alekhyageddam/BNav/HaptiGoVestCode/HaptiGoClean/Reports/IUI 2013/Haptigo Paper.pdf

# HaptiGo: An Intelligent and Lightweight Tactile Vest for Improving Active Pedestrian Navigation Experiences

Anonymous

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

Author Keywords
Mobile user interface, haptics, tactile display, pedestrian navigation, intelligent fabrics.

ACM Classification Keywords
H.5.2. User Interfaces: Haptic I/O

INTRODUCTION
As people navigate from one location to another by foot, they can take advantage of prior knowledge of their surroundings to guide themselves towards their intended destinations. Greater familiarity in their environments from this prior knowledge also enables people to engage in multi-tasking while making the most of their available time, alleviating any boredom, and so on. These parallel tasks in conjunction with navigation are also quite diverse in scope and can range from social activities, such as engaging in serious discussion with colleagues, casually texting with a friend, or talking

Submitted to IUI’13.
Do not cite, do not circulate.

to family on the phone; to more personal activities, such as listening to music with headphones, browsing information on a smartphone, or playing video games on a portable gaming device.

These habits subsequently introduce two distinct challenges as people grow accustomed to multi-tasking while navigating familiar environments: the challenge of inconvenience where people must become more aware of their surroundings and navigation tools in unfamiliar environments due to lack of prior knowledge, and the serious challenge of exposing people to greater danger while navigating in more active environments [17]. While the former challenge is readily apparent, the latter challenge occurs especially to individuals who suffer from situation-induced impairments [15], which is when they lose awareness about the situation around, such as through secondary tasks and self-imposed distractions when multi-tasking during pedestrian navigation. Examples include frequent cases of people bumping into others while their attention is focused on their mobile devices [17], and the loss of situational awareness (i.e., iPod Zombie trance) while listening to loud music that have also led to rising rates of pedestrian fatalities [27].

Conventional navigation systems found on multitudes of mobile devices – especially those which typically rely on either visual or auditory modalities – prove lacking when it comes to addressing the specifics from these particular challenges. In response, various studies have shown the effectiveness of navigation solutions which instead utilize alternate tactile modalities, especially when users are cognitively occupied in performing other tasks [8]. Moreover, touch provides great appeal in communicating navigation information without simultaneously introducing mental distraction, since tactile sensory channels are hardly affected when utilized to observe peoples surroundings [27]. According to related theoretical frameworks [8, 36], the tactile modality has great appeal as it can serve to guide, reduce workload, and support situation and navigation performance.

There is great potential in developing an effective tactile navigation system which supports the types of behaviors contained in these challenges. We therefore propose HaptiGo, a lightweight haptic vest which provides navigation intelligence of tactilely guiding pedestrians to their intended destinations and away from potential obstacles through well-placed vibro-tactile sensors, while providing natural and small form factor interaction cues which emulate the invisible sensation of being passively guided in the right direction.

We individually evaluated our vest on a group of pedestrians navigating through several different waypoints while engaged in cognitively demanding tasks, and our results demonstrated that users navigated to their destinations effectively and enjoyed our haptic interface solution.

Design Constraints
In order to design an intelligent user interface for pedestrian navigation that addressed our proposed challenges, we first had to explore design constraints that both intelligently and intuitively navigated users. The interaction analogy that inspired our design of HaptiGo was that of a friendly guide whom physically nudged the user towards the right direction and away from potential hazards.

Tactile Feedback
One analogy that we explored and expressed interest in involved interaction cues which emulated the physical action of appropriately nudging users during navigation. That is, an interaction that emulated a guide reaching out to the user and physically directing them in a friendly manner. In this case, we desired a tactile interface which provided feedback on the user’s upper torso area, since it was an ideal region for providing emulated interaction cues in nudging a person towards and away from points of interest.

Navigation Guidance
Once we established on a desired model of the tactile feedback, we needed to decide on interaction cues which serve to guide the users effectively and intuitively. The analogy that we sought was one where a guide would gently nudge users to the desired area, such as tapping the user from behind towards the intended direction.

Obstacle Avoidance
The complementary interaction of guiding users towards their target would be in guiding users away from potential hazards, so we also needed to decide on interaction cues to express that type of behavior. The analogy that interested us was a guide whom would reach out in front of the user and block the user from progressing any further due to an incoming hazard.

Example Scenarios
Our system is designed for scenarios where the users are engaged in multitasking while navigating. Th ser isn tsuch scenarios use passive awareness ofh the environment to navigate. The following scenarios illustrate the situations where a user could take advantage of our system. George is a paratrooper in airborne troops. He is on an operation that involves him to parachute into enemy territory with other Soldiers. Once he has landed, he has to reorient himself and find his way to the rendezvous point. Since he is in an hostile terrain, he should maintain awareness about the space around him, maintain his stealth and navigate through the unfamiliar terrain. George could use HaptiGo to offload the cognitive task of navigation while maintaining an awareness of the space around him.

Stacy is a player of the game called geocaching. The game involves Stacy finding hidden treasure at a given location. The latitude and longitude of the treasure is specified in the game. Stacy would have to navigate to this location and search for treasure in an unfamiliar terrain. Stacy could use our HaptiGo system to help her find obstacle on her path and navigate through the terrain while she is engaged in finding the treasure given at the location.

Maggie is an undergraduate student in a university. She has just finished her class in building A and has a class in building
B. She receives a text from her friend. While she is typing a reply to her friend, she has to walk to building B through a route that is busy with students. Maggie could use our system to help her multi-task while walking from building A to B. HaptiGo will help her navigate through the crowded route augmenting her awareness of the environment which is decreased while texting.

RELATED WORK
Research work as far back as over a decade ago [30] has focused on the development of pedestrian navigation systems that either additionally included or alternatively incorporated tactile modalities. While not primarily targeting people with situation-induced impairments, such systems have been developed to accommodate various other pedestrian types such as tourists in unfamiliar environments (e.g., [27, 33]), soldiers in sensitive environments (e.g., [7, 8]), and vision-impaired individuals in bustling environments (e.g., [13, 22]). Furthermore, these systems propose diverse solutions which take full advantage of tactile modalities in pedestrian navigation, ranging from mobile user interfaces which exploit mobile communication devices’ vibration alerts to wearable tactile displays such as vibrotactile belts and vests.

Mobile User Interfaces
The global ubiquity of mobile devices such as the recent generation of smartphones have motivated researchers to build multitudes of mobile navigation apps with tactile feedback support by taking advantage of those mobile devices’ built-in vibrating alert feature. These various solutions provide their own approaches that build upon the existing capabilities of mobile phone technologies and can be categorized into two different types: magic wand and sixth sense [12].

Magic Wand
Mobile user interfaces which incorporate magic wand functionality take their cues from the metaphor of pointing the device at a distant object to learn more about its presence and access its corresponding information [12], and have been made specifically more feasible with recent mobile devices such as smartphones due to increased built-in digital compass capabilities [27]. In the context of pedestrian navigation, mobile user interfaces which incorporate magic wand functionality have recently been utilized to actively scan the user’s surroundings, such as physically waving the mobile device with their arms stretched out forward or turning their bodies around with the mobile device in their possession [19, 20], and for different purposes, such as better guidance for the visually-impaired individuals [18], more flexible routes for exploring tourists [29], and improved streamlined meetups for social groups [37].

These magic wand interfaces have proven successful in terms of intuitiveness from user feedback, and evaluations from these cited examples have demonstrated that users are able to reach target destinations effectively (e.g., [19, 29, 37]). While these systems benefit interface pedestrians through more intuitive navigation through a magic wand metaphor, this intuitiveness comes at the cost of requiring users to be actively engaged with these interfaces [29]. Consequently, not only would this type of interaction be cumbersome and exhausting to users over prolonged use as they adjust their limbs or bodies while locating their target destinations, but users with situation-induced impairments would not be able to benefit from such interfaces as they would require active engagement with these interfaces.

Sixth Sense
Alternative techniques to the magic wand metaphor have instead adopted a sixth sense metaphor, which describes the interaction technique of using multimodal feedback to alert the user about changes within the environment [12]. In the context of pedestrian navigation, sixth sense-based interfaces enable users to derive the location of their target destinations in relation to their current location and orientation [27].

Techniques that rely on the sixth sense metaphor have provided their own implementations either through turn-by-turnbased vibration patterns (e.g., [16, 28]) or compass-based directional vibration cues (e.g., [7, 25, 26, 31, 33]). In comparison to magic wand interfaces, sixth sense interfaces benefit users through more passive interaction; in other words, users are not required to search for spatial entities by explicitly performing pointing gestures. Consequently, the lack of such active gesturing to physical directions in sixth sense interfaces means that these interfaces are less intuitive and possess a steeper learning curve. As a result, users must first understand the directional meaning of the mobile devices’ vibration feedback (e.g., meaning of vibration patterns, context of vibration cues) before they may be able to successfully navigate to their target destinations.

Magic Wand + Sixth Sense
Insights extracted from the contributions of these existing tactile-based mobile user interfaces have enabled researchers to explore possible synergies in a hybrid technique of both magic wand and sixth sense, such as applying vibration patterns from magic wand techniques that also expressed the direction of target destinations relative to the mobile device found in sixth sense techniques (e.g., [19, 24, 25]). Efforts from these explorations demonstrated that improvements were achievable for interfaces combining the strengths of both magic wand and sixth sense techniques; these subsequent interfaces accomplished the intuitive strengths of magic wand techniques with the passive capabilities of sixth sense interfaces without requiring that pointing gestures be executed.

While more recent navigation interfaces enjoy the benefits in magic wand and sixth sense techniques, one limitation that the hybrid technique possessed stemmed from evaluations which demonstrated lingering intuitiveness issues such that users required further training in order to utilize tactile feedback for pedestrian navigation [27]. Moreover, theoretical frameworks revealed that the placement of tactile information was critical to be intuitively comprehended by users [8, 35]; in the case of the hybrid technique, this tactile information is singularly expressed from the vibrating alarm of the mobile device which less effectively and intuitively conveys navigation information when carried by hand or in clothing compared to techniques which incorporate additional and more optimally placed tactile sensors (e.g., tactile displays). An additional limitation of the hybrid technique stems from the hardware (i.e., the mobile device’s vibrating alarm) used for expressing tactile information when additionally including obstacle detection; further intuitiveness issues may develop from the ambiguity of determining whether cues from the vibration alarm indicate either navigation guidance or obstacle detection.

Wearable Tactile Interfaces
While tactile mobile user interfaces for pedestrian navigation have experienced greater developments following the growing ubiquity of smartphones and more advanced feature phones [27], earlier tactile navigation systems consisted of wearable tactile interfaces (e.g., [30, 34]) which continued evolving in terms of smaller form factor and improved intuitiveness (e.g., [9, 22]). Wearable tactile interfaces are also not constrained to a single vibrotactile sensor (i.e., vibrating alarm) on mobile phones like in mobile user interfaces, so these interfaces also enable richer feedback (e.g., more sensors, more optimal placement of interface) and greater flexibility (e.g., less constraints on placement of interface). Recent technological advances and near-future ubiquitious possibilities of intelligent fabrics (e.g., [6]) have further made wearable tactile interfaces viable options for providing tactile navigation assistance. Various earlier wearable tactile interfaces proposed placing devices on different regions of the body, ranging from the upper body (e.g., head, shoulders, torso) to the lower body (waist, feet), and researchers have reported that the most successful interfaces were specifically placed either on the waist (i.e., tactile belts) or on the torso (i.e., tactile vests) [32].

Tactile Belts
Various proposed tactile belts systems for pedestrian navigation share similar characteristics in embedding vibrotactile sensors around the waist which generate absolute point pulses analogous to receiving visual from a compass [32]. Earlier tactile belt prototypes (e.g., [10, 11, 13, 21, 34] provided tactile feedback on larger, protruding belts that guided users with navigational feedback from a backpack-carried laptop or nearby server, while more recent tactile belt systems (e.g., [22, 23]) achieved small form factors similar to clothing belts and with navigational guidance from GPS-enabled smartphones.

Some of the advantages demonstrated by tactile belt designs included users intuitively understanding the direction cues from the tactile feedback [11] and performing better compared to wearing early-generation pattern-based tactile vests in controlled studies [32]. An observation we made with tactile belt designs though involved additionally incorporating obstacle detection functionality; since sensors on existing tactile belt systems are equally-spaced around the user’s waist, this introduced the possibility of usability issues of interpreting what tactile feedback would indicate navigational cues and what would indicate obstacle avoidance.

Tactile Vests
Wearable tactile interfaces for pedestrian that are alternative to tactile belts are tactile vests, which consist of torso vests and embedded with a set of vibrotactile sensors; early-generation vests were bulkier and supported sensors which generated straight-line patterns (e.g., directional gestures) [14, 30] which functioned as pulsating sequences, while more recent vests were better streamlined and supported relative point vibrations on the backside of the user (e.g., left, forward, right) [7, 8, 9] during navigation.

Recent tactile vest approaches have demonstrated advantages including their effectiveness in displaying direction cues based on both controlled and preliminary field studies
[8] and in navigating users without distracting them [22]. Moreover, various theoretical frameworks (e.g., Wickens’ Multiple Resource Theory [36], van Erp’s Prenav model [35]) provide supporting evidence on the effectiveness of tactile vests in improving various aspects of navigation. The Prenav model particularly theorizes that simply providing tactile information in navigation is not enough, and observations have shown that direction information can be intuitively comprehended with torso-placed sensors such as on tactile vests [8]. While the cited works on tactile vests focus specifically on pedestrian navigation tasks, the tactile vest approach specifically appealed to us due to their supported intuitive benefits and also provided design constraints which supported both navigation guidance and obstacle avoidance functionality through more natural interaction cues.

IMPLEMENTATION
The Haptigo System consists of a LilyPad Arduino [2], a Nexus One Android smartphone [1], the BlueSmirf Bluetooth module [3], an Ultrasonic Ping Sensor [5], and five LilyPad Vibe Boards ( vibrational tactors) [4]. Figure 1 shows a schematic diagram of the components used in the system. The haptigo system has two functionality - navigation and obstacle detection.


Figure 1. Schematic diagram of the components used in Haptigo.

Navigational Feedback


(a) Position of vibrational tactors used for navigation in Haptigo.


(b) Rear view of user wearing Haptigo vest.

Figure 2. Rear view of haptigo vest.

To implement the navigation functionality of the Haptigo system, we used an Android smartphone [1] as a source of location updates (GPS), as a measure of the alignment of the user (magnetometer) and also as, a processing unit (for calculating the directional cues). The directional cues calculated by Android [1] were communicated to the Lilypad Arduino
[2] by using the Bluesmirf [3], bluetooth chip. The Lilypad Arduino [2] in turn activates one of the three vibrational tactors that gives directional cues.

We use three vibrational tactors for conveying navigational information. One vibrational tactor for suggesting left turn, one for right turn and one for going straight. Three vibrational tactors are arranged in a Y pattern on the left back shoulder, right back shoulder and the center back of the wearer. All the three vibrational tactors are situated on the back side of users torso. Figure 2(a) illustrates the position of tactors on back side of torso. This arrangement was found to be intuitive as users instinctively turned left when the left tactor was activated, and turned right when the right tactor was activated.

A directional haptic cue is encoded as three distinct, consecutive vibration pulsed 0.5 seconds apart. The direction to turn is conveyed to the user by the location of the vibrating tactor i.e. a vibrating tactor on the left shoulder indicates the wearer should begin a left turn, a vibrating tactor on the right shoulder indicates a right turn, and lastly a vibrating tactor in the center of the back indicates the wearer should keep on straight.

We chose pulses based on our feedback from initial pilot study. A continuous vibrational feedback was interpreted as a push and a pulsed vibrational signal was interpreted as tap on the shoulder. The continuous and pulsed signals stimulate opposite responses from the user. A continuous vibrational signal on the right shoulder would make the user turn left because s/he would interpret it as someone pushing him/her in the counterclockwise direction. A pulsed signal on the right shoulder would make the user turn right because s/he interprets it as someone tapping him/her on right shoulder. This evokes the user to turn right.

Obstacle Detection


(a) Position of vibrational tactors used for obtacle detection in Haptigo.


(b) Front view of user wearing Haptigo vest.

Figure 3. Front view of haptigo vest.

The second functionality of our system was to alert the wearer to approaching obstacles within his/her immediate vicinity. Two ultrasonic ping sensors [5] are used to find obstacles in the users vicinity. The ping sensors are placed just below the users neck. One sensor is placed to the left just above the users chest and another sensor is placed to the right just above the users right chest. The left sensor detects obstacles approaching the users from his/her left and the right sensor detects the obstacles approaching the users from his/her right. The Lilypad Arduino [2] reads the input from two ultrasonic ping sensors, detects the existence of an obstacle and calculates the movement of the obstacle relative to the user.

The LilyPad Arduino activates either of the two vibrational tactors to notify the users, The two vibrational tactors are placed just below right and left users chest area. An approaching obstacle on the right is alerted using right vibrational tactor and an approaching obstacle on the left is alerted using left vibrational tactor. A haptic cue for an obstacle is encoded as one vibrational pulse of 1 second. We have designed the system to alert users when the obstacles are approaching. The system does not alert the user when an obstacle is detected. It alerts the user when an obstacle moves closer to the user. Figure 3(a) illustrates the position of tactors on front side of torso.

EVALUATION
We performed two studies to evaluate our system - a pilot study with four users and a user study with ten users. There was one female participant and three male participants in the pilot study. In the user study, we had two female participants and eight male participants.

In the pilot study, the users wore the haptigo vest and then were directed along a pre-determined route. The route consisted of one right turn and one left turn. Figure 4 shows the route used in the pilot study. The starting and ending points of the pilot study are illustrated with an ’X’ symbol. In addition to testing the system functionality, we collected feedback from the user regarding the intuitiveness of the haptic cues used in the system.


Figure 4. Route taken by participants in pilot study.

In our user study, we compared our system against Pocket-Navigator[24]. PocketNavigator[24], an Android application, uses vibrational tactor in the smartphone to provide haptic cues for direction. Figure 5 illustrates the haptic cues used by PocketNavigator[24] for each direction. The haptic cue for straight is two consecutive short pulse, the haptic cue for left is one long pulse followed by a short pulse, the haptic cue for right is a short pulse followed by a long pulse and the haptic cue for turning back is three consecutive short pulses. The length of vibration, the order of vibrational pulses and the number of pulses in a haptic cue is used to differentiate the direction.


Figure 5. Directional cues presented by PocketNavigator, Android app.

We used the following scenario to compare Haptigo with PocketNavigator[24]. A user wants to navigate from building A to building B in his university. While walking to the destination, she needs to type in a text using her smartphone. She opens up the Haptigo/ PocketNavigator[24] app in her smartphone. Types in the destination. She uses Haptigo/ PocketNavigator[24] to help her navigate to the destination while texting on her way to building B.

The navigation route was predetermined in our User study. Figure 6 shows the route taken by the user for user study. As before with the pilot study image, the starting and ending points are illustrated with an ’X’ symbol. We designated a starting and ending point for all users. The predetermined route was setup to ensure that a large amount of obstacles (pedestrians, and construction equipment) would be included in the path. In order to avoid familiarity of the user with a particular route, waypoints were setup as mandatory checkpoints before the destination could be reached. This mandatory checkpoint was implemented to be transparent to the user of the Haptigo System .In our scenario, texting is used as the secondary task. Every user in this study will have to navigate from point A to point B while texting. The experimenter will provide the text to be typed.


Figure 6. Route taken by participants in user study.

Each user in the user study was given training with both the PocketNavigator[24] and Haptigo systems. In the case of PocketNavigator[24], the user was trained to decipher the vibration signals output by the phone. In the case of the Haptigo system, users went through a calibration step. In the calibration step, each of the five vibrational tactors were activated in order to teach the user how to decipher these signals. After the calibration step, users demonstrated an understanding that the vibrational tactors located in the back of the Haptic Vest signaled directional cues while the vibrational tactors located in the front of the Haptic Vest signaled obstacle cues.

The user performed the navigation task twice. Once with PocketNavigator[24] and the other time with the Haptigo system. The route taken between points A and B for Pocket-Navigator[24] and Haptigo were different. However, the number of waypoints situated in the route along with the route length were kept approximately equal for the routse used in the PocketNavigator[24] and Haptigo System.

The Independent Variable in the user study was the navigation system that was used. The Dependent Variables were the typing rate of users, and the time taken by the user to move from point A to B. At the end of the user study, users filled a questionnaire asking users to rate their experience with the system on a five-point likert scale. The users rated each of the systems based on the following metrics: ease of use in navigation, haptic cues for navigational directions, and haptic cues for approaching obstacles (if applicable). Any subjective feedback from the user about the system was recorded.

RESULTS
We collected feedback from four users in our pilot study. In our initial system, haptic cues for direction were encoded as a single continuous signal. For example: If the intended navigation direction was to the right, the vibrational tactor at the right-back shoulder would turn on for one second. Two of the users felt such a feedback was equivalent to a push from the back causing the users to make a left turn instead of right. This feedback from the users prompted a change in the duration of the haptic cues from one continuous pulse to three consecutive pulse spaced 0.5 seconds apart. The consecutive haptic cues were considered by users to be similar to taps on the shoulder rather than push. So a haptic cue on the right shoulder had the user turn right.

A third user stated that the haptic cues for obstacles were unintuitive. In our initial system, users were alerted when the system detected an obstacle. Our third user remarked that, It is more intuitive to know if an obstacle is approaching me than an obstacle which is either stationary or moving away from me. Based on this feedback, we changed our system where it detects the movement of obstacle relative to the user. The system then notifies the user when the obstacle moves closer relative to the user.

We collected navigation time and typing rate data from the user study. We also collected ease of use and feedback on directional cues in Haptigo and PocketNavigator[24]. The mean and standard deviation for navigation time and typing rate are provided in Table 1. Figure shows the distribution of navigation time across ten participants and Figure 8 shows the distribution of typing rate across ten users. One user did not want to do the typing task when she performed navigation using PocketNavigator[24]. She stated it was inconvenient to type while using the PocketNavigator[24]. In order to remove the bias, we used her navigation time but removed typing rate entry from calculating mean and standard deviation.

Directional Cues | Haptigo (Mean / SD) | PocketNavigator (Mean / SD)
Left | 11.32 / 5.74 | 8.51 / 2.37
Right | 31.6 / 19.83 | 26.78 / 12.14
Table 1. Mean / Standard Deviation of Navigation Time and Typing Rate of users while using Haptigo and PocketNavigator.


Figure 7. Distribution of navigation time across ten particpants.

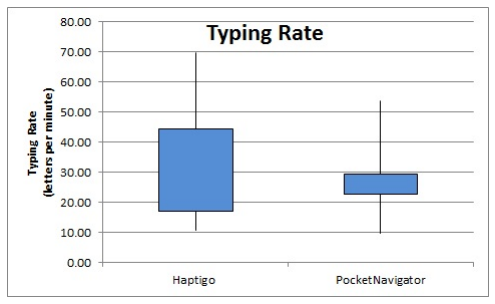
[picture p13: figure]

Figure 8. Distribution of typing rate across ten participants.

The mean and standard deviation for user ratings on ease of use of the system and directional cues provided by the system are provided in Table 2. Figure[] shows the distribution of user ratings for Haptigo Direction Cues and Figure[] shows the distribution for PocketNavigator[24] Direction Cues. Five users stated that the haptigo system detected obstacles. Other users stated that they did not run into any obstacle during the navigation. Two users stated that there was one instance where the system alerted the user when there was no obstacle.

Directional Cues | Haptigo (Mean / SD) | PocketNavigator (Mean / SD)
Left | 4.2 / 1.03 | 4 / 1.24
Right | 4.2 / 1 | 3.8 / 1.22
Straight | 3.6 / 0.84 | 4 / 1.33
Table 2. Mean / Standard Deviation of directional haptic cues for Haptigo and PocketNavigator.


Figure 9. Distribution of user ratings for direction cues of Haptigo.


Figure 10. Distribution of user ratings for direction cues of PocketNavigator.

DISCUSSION
The users were able to perform the navigation task without any mistakes. The users could perceive the directional and obstacle cues easily. The users noted that the strength of the haptic cue for the straight direction in the Haptigo was weak; it was difficult to perceive the vibrational signal. This is because the vibrational tactor for the straight direction is located just above the dip in the spinal region of the back. This tactor does not touch firmly against the body and thus is thus imperceptible to users. This can be remedied by substituting two vibrational tactors in place one for straight direction cue to make the vibrational signal stronger. The vibrational tactors could also be moved away from the center dip in the back in order to increase their strength.

The analysis of data collected from the user study showed that the performance of Haptigo was on par with the PocketNavigator[24]. The average navigation time for users with Haptigo (11.32 minutes) was higher than the navigation time for PocketNavigator[24]. The Paired T - Test on navigation times for the Haptigo and PocketNavigator[24] Systems shows that T(alpha ¡ 0.05) = 0.15. Thus, the navigation time differences reported above were not statistically significant.

The average typing rate for a user using Haptigo (31.6 letters per minute) was greater than typing rate of the same user using PocketNavigator[24] (26.7 letters per minute). Paired T - Test for typing rate shows that T(alpha ¡ 0.05) = 0.42. The typing rate differences were not statistically significant. The performance of Haptigo could not be proved to be neither better nor worse than PocketNavigator[24]. Users rating for the directional cues for both systems were similar. Paired T
- Test on user ratings for left , right and straight directional cues (T(alpha¡ 0.05)) are 0.69, 0.42 and 0.30. The user ratings for directional cues used in Haptigo and PocketNavigator[24] were not statistically different.

While using PocketNavigator[24], One of the users asked the experimenter to alert him of any approaching obstacle since he was occupied with the task. The significant difference between both the systems is the awareness of the users environment provided by Haptigo. The average user rating for the haptic cues for obstacles was 4 with a standard deviation of
1.3. The cause for this deviation is attributed to a low rating for the haptic cues for obstacle avoidance. This low rating stemmed from the feedback of a user who was presented with a haptic cue for obstacle avoidance when there was no relevant obstacle within the immediate vicinity.

Five users stated that they were alerted of an approaching obstacle in the path while using Haptigo. Two users stated there were alerts of an obstacle when there were none in the path. This could be caused due to a wrong sensor reading. These instances were infrequent and had minimal influence on the overall navigation task. One user stated that the Haptigo system did not notify her when she walked into the low lying branch of a tree. We attribute this error to the limitations of ultrasonic sensors. Objects smaller in size (like thin tree branches) can often be missed as they do not present a large enough area to reflect the the initial incident pulse transmitted by the ultrasonic sensors. This limitation can be managed by approaching the object.

FUTURE WORK
There were two concerns stated by the participants of the user study. One is the weak direction haptic cue for going straight and the other is the false positive in error detection. We would like to address the first concern by replacing one tactor in the lower back with two tactors and placing it equidistant from the center of the back. This would ensure that the vibrational tactors touch the user firmly in the back and the straight haptic cue is strong enough to be perceived.

CONCLUSION
We have designed a wearable computing device which can act as a navigational aid for the user and maintain users awareness about his/her environment by detecting approaching obstacles. The users could perform the navigation task and identify obstacles after performing a calibration task and without a training. The position of the vibrational tactors and haptic cue presented were intuitive for the navigation and obstacle detection. We performed a user study with ten users to compare the performance of Haptigo as a navigational aid when compared to PocketNavigator[24]. For this sample of users, we found that the performance of Haptigo system was in par with PocketNavigator[24] in terms of navigation time and text typing rate. The advantage of using Haptigo system is provides awareness about the users environment by detecting approaching obstacles.

REFERENCES
1. Android website. http://www.android.com/, 2012.
2. Arduino website. http://www.arduino.cc/, 2012.
3. Bluesmirf product page.

http://www.rovingnetworks.com/products/RN_42,
2012.
4. Lilypad product page.

https://www.sparkfun.com/products/11008, 2012.

5. Pingsensor product page. http://www.parallax.com/

tabid/768/ProductID/92/Default.aspx, (http://www.parallax.com/tabid/768/ProductID/92/Default.aspx) 2012.

6. Buechley, L., Eisenberg, M., Catchen, J., and Crockett,
A. The lilypad arduino: using computational textiles to investigate engagement, aesthetics, and diversity in computer science education. In Proceedings of the SIGCHI Conference on Human Factors in Computing Systems, CHI ’08, ACM (New York, NY, USA, 2008), 423–432.
7. Cummings, D., Lucchese, G., Prasad, M., Aikens, C., Ho, J., and Hammond, T. Haptic and ar interface for paratrooper coordination. In Proceedings of the 13th International Conference of the NZ Chapter of the ACM’s Special Interest Group on Human-Computer Interaction, CHINZ ’12, ACM (New York, NY, USA, 2012), 52–55.
8. Elliott, L., van Erp, J., Redden, E., and Duistermaat, M. Field-based validation of a tactile navigation device. Haptics, IEEE Transactions on 3, 2 (april-june 2010), 78–87.
9. Elliott, L. R., Schmeisser, E. T., and Redden, E. S. Development of tactile and haptic systems for u.s. infantry navigation and communication. In Proceedings of the 2011 international conference on Human interface and the management of information - Volume Part I, HI’11, Springer-Verlag (Berlin, Heidelberg, 2011), 399–407.
10. Erp, J. B. F. V., Veen, H. A. H. C. V., Jansen, C., and Dobbins, T. Waypoint navigation with a vibrotactile waist belt. ACM Trans. Appl. Percept. 2, 2 (Apr. 2005), 106–117.
11. Erp, J. B. F. V., Veen, H. A. H. C. V., Jansen, C., and Dobbins, T. Waypoint navigation with a vibrotactile waist belt. ACM Trans. Appl. Percept. 2, 2 (Apr. 2005), 106–117.
12. Frohlich, P., Oulasvirta, A., Baldauf, M., and Nurminen, ¨
A. On the move, wirelessly connected to the world. Commun. ACM 54, 1 (Jan. 2011), 132–138.
13. Johnson, L., and Higgins, C. A navigation aid for the blind using tactile-visual sensory substitution. In Proceedings of the 28th Annual International Conference of the IEEE Engineering in Medicine and Biology Society, EMBS ’06, IEEE (2006), 6289–6292.
14. Jones, L. A., Nakamura, M., and Lockyer, B. Development of a tactile vest. In Proceedings of the 12th international conference on Haptic interfaces for virtual environment and teleoperator systems, HAPTICS’04, IEEE Computer Society (Washington, DC, USA, 2004), 82–89.
15. Jupp, J., Langdon, P., and Godsill, S. Mobile computing in maintenance activities: A ’situational induced impairments and disabilities’ perspective. In Universal Acess in Human Computer Interaction. Coping with Diversity, C. Stephanidis, Ed., vol. 4554 of Lecture Notes in Computer Science. Springer Berlin / Heidelberg, 2007, 696–705.
16. Lin, M.-W., Cheng, Y.-M., Yu, W., and Sandnes, F. E. Investigation into the feasibility of using tactons to provide navigation cues in pedestrian situations. In Proceedings of the 20th Australasian Conference on Computer-Human Interaction: Designing for Habitus and Habitat, OZCHI ’08, ACM (New York, NY, USA, 2008), 299–302.
17. Madden, M., and Rainie, L. Adults and cell phone distractions. Tech. rep., Pew Research Center, June 2010.
18. Magnusson, C., Molina, M., Rassmus-Grohn, K., and ¨ Szymczak, D. Pointing for non-visual orientation and navigation. In Proceedings of the 6th Nordic Conference on Human-Computer Interaction: Extending Boundaries, NordiCHI ’10, ACM (New York, NY, USA, 2010), 735–738.
19. Magnusson, C., Rassmus-Grohn, K., and Szymczak, D. ¨ The influence of angle size in navigation applications using pointing gestures. In Proceedings of the 5th international conference on Haptic and audio interaction design, HAID’10, Springer-Verlag (Berlin, Heidelberg, 2010), 107–116.
20. Magnusson, C., Rassmus-Grohn, K., and Szymczak, D. ¨ Scanning angles for directional pointing. In Proceedings of the 12th international conference on Human computer interaction with mobile devices and services, MobileHCI ’10, ACM (New York, NY, USA, 2010), 399–400.
21. Nagel, S. K., Carl, C., Kringe, T., Martin, R., and K ¨ | onig, ¨
P. Beyond sensory substitution—learning the sixth sense. J. Neural Eng. 2, 4 (Nov. 2005), R13–R26.

22. Pielot, M., and Boll, S. Tactile wayfinder: Comparison of tactile waypoint navigation with commercial pedestrian navigation systems. In Pervasive Computing,
P. Floreen, A. Krger, and M. Spasojevic, Eds., vol. 6030 ´ of Lecture Notes in Computer Science. Springer Berlin / Heidelberg, 2010, 76–93.
23. Pielot, M., Henze, N., and Boll, S. Supporting map-based wayfinding with tactile cues. In Proceedings of the 11th International Conference on Human-Computer Interaction with Mobile Devices and Services, MobileHCI ’09, ACM (New York, NY, USA, 2009), 23:1–23:10.
24. Pielot, M., Poppinga, B., and Boll, S. Pocketnavigator: vibro-tactile waypoint navigation for everyday mobile devices. In Proceedings of the 12th international conference on Human computer interaction with mobile devices and services, MobileHCI ’10, ACM (New York, NY, USA, 2010), 423–426.
25. Pielot, M., Poppinga, B., Heuten, W., and Boll, S. 6th senses for everyone!: the value of multimodal feedback in handheld navigation aids. In Proceedings of the 13th international conference on multimodal interfaces, ICMI ’11, ACM (New York, NY, USA, 2011), 65–72.
26. Pielot, M., Poppinga, B., Heuten, W., and Boll, S. A tactile compass for eyes-free pedestrian navigation. In Proceedings of the 13th IFIP TC 13 international conference on Human-computer interaction - Volume Part II, INTERACT’11, Springer-Verlag (Berlin, Heidelberg, 2011), 640–656.
27. Pielot, M., Poppinga, B., Heuten, W., and Boll, S. Pocketnavigator: studying tactile navigation systems in-situ. In Proceedings of the SIGCHI conference on Human factors in computing systems, CHI ’12, ACM (New York, NY, USA, 2012), 3131–3140.
28. Raisamo, R., Nukarinen, T., Pystynen, J., Makinen, E., ¨ and Kildal, J. Orientation inquiry: a new haptic interaction technique for non-visual pedestrian navigation. In Proceedings of the 2012 international conference on Haptics: perception, devices, mobility, and communication - Volume Part II, EuroHaptics’12, Springer-Verlag (Berlin, Heidelberg, 2012), 139–144.
29. Robinson, S., Jones, M., Eslambolchilar, P., Murray-Smith, R., and Lindborg, M. ”i did it my way”: moving away from the tyranny of turn-by-turn pedestrian navigation. In Proceedings of the 12th international conference on Human computer interaction with mobile devices and services, MobileHCI ’10, ACM (New York, NY, USA, 2010), 341–344.
30. Ross, D. A., and Blasch, B. B. Wearable interfaces for orientation and wayfinding. In Proceedings of the fourth international ACM conference on Assistive technologies, Assets ’00, ACM (New York, NY, USA, 2000), 193–200.
31. Rumelin, S., Rukzio, E., and Hardy, R. Naviradar: a ¨ novel tactile information display for pedestrian navigation. In Proceedings of the 24th annual ACM symposium on User interface software and technology, UIST ’11, ACM (New York, NY, USA, 2011), 293–302.
32. Srikulwong, M., and O’Neill, E. A comparison of two wearable tactile interfaces with a complementary display in two orientations. In Proceedings of the 5th international conference on Haptic and audio interaction design, HAID’10, Springer-Verlag (Berlin, Heidelberg, 2010), 139–148.
33. Szymczak, D., Rassmus-Grohn, K., Magnusson, C., and ¨ Hedvall, P.-O. A real-world study of an audio-tactile tourist guide. In Proceedings of the 14th international conference on Human-computer interaction with mobile devices and services, MobileHCI ’12, ACM (New York, NY, USA, 2012), 335–344.
34. Tsukada, K., and Yasumrua, M. Activebelt: belt-type wearable tactile display for directional navigation. In Proceedings the Sixth International Conference on Ubiquitous Computing 2004, UbiComp ’04 (2004), 384–399.
35. van Erp, J. Tactile displays for navigation and orientation: perception and behavior. PhD thesis, Utrecht University, 2007.
36. Wickens, C. Multiple resources and performance prediction. Theoretical Issues in Ergonomics Science 3, 2 (2002), 159–177.
37. Williamson, J., Robinson, S., Stewart, C., Murray-Smith, R., Jones, M., and Brewster, S. Social gravity: a virtual elastic tether for casual, privacy-preserving pedestrian rendezvous. In Proceedings of the SIGCHI conference on Human factors in computing systems, CHI ’10, ACM (New York, NY, USA, 2010), 1485–1494.
