alekhyageddam/BNav/HaptiGoVestCode/HaptiGoClean/Reports/IUI 2013/Images/BlueSmirf.jpg

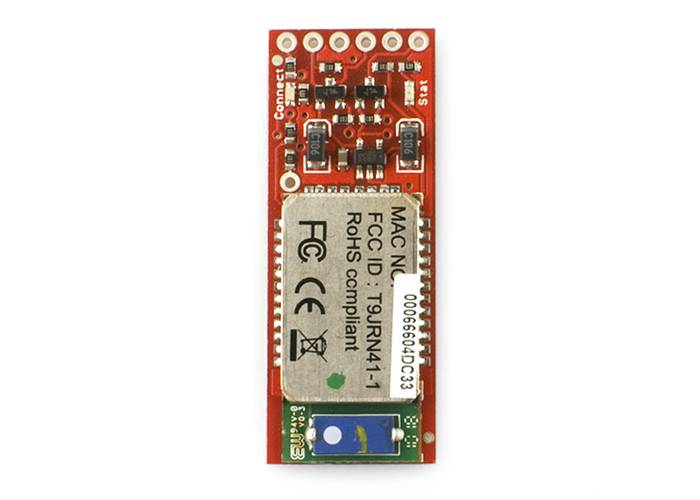
HaptiGoVestCode/HaptiGoClean/Reports/IUI 2013/Images/BlueSmirf.jpg
