alekhyageddam/BNav/HaptiGoVestCode/HaptiMotoGame/ic_launcher-web.png

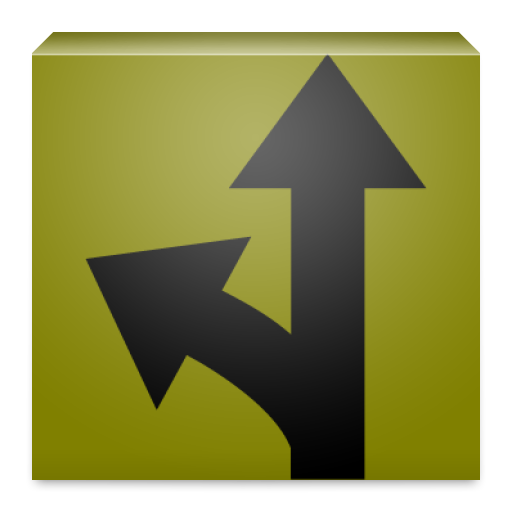
HaptiGoVestCode/HaptiMotoGame/ic_launcher-web.png
